SenudaHR/Buck-Converter-Design/README.md

# Design-and-Implementation-of-a-Buck-Converter-for-DC-Voltage-Regulation
