SenudaHR/Buck-Converter-Design/Project Report.pdf

Department of Electronic & Telecommunication Engineering, University of Moratuwa, Sri Lanka.

# Design and Implementation of a Buck Converter for DC Voltage Regulation

Group Members:
230130E | Deshan W. U.
230138K | Dhananjaya K. T. G. T. N.
230155J | Dissanayaka D. M. D. P.
230548R | Ratnayake R. M. S. H.

Submitted in partial fulfilment of the requirements for the module EN2111 Electronic Circuit Design

Date: June 23, 2026

Closed Loop Buck Converter | Group 10

## Contents

1 Introduction and Functionality | 2
2 System Architecture | 3
3 Detailed Design | 6
4 Component Selection | 8
5 Software Simulation | 10
6 Analysis & Discussion | 12
7 Challenges and Future Improvements | 16
A Overall Circuit Diagram | 18

1

## 1 Introduction and Functionality

DC voltage regulation is vital for delivering stable power to sensitive electronics. While simple, linear regulators waste excessive energy as heat. This project implements a step-down (Buck) Switch-Mode Power Supply (SMPS) to efficiently convert a 15 V input down to a regulated 3 V to 12 V output at a 1 A load current.

### 1.1 System Operational Overview

As illustrated in Figure 1, the system maintains a stable output voltage via a continuous closed-loop feedback mechanism consisting of four main stages:

- Power Stage: Uses an IRF3205 MOSFET switch and a 1N5819 freewheeling diode alternating at 18 kHz to chop the input voltage. A second-order LC low-pass filter smooths this chopped signal into a clean DC output.
- Feedback Network (K): A resistive voltage divider continuously samples the output voltage (VOUT ) and scales it down to safe signal levels for the control circuitry.
- Error Amplifier (A(s)): An NE5532 op-amp compares the scaled feedback voltage against a highly stable 2.495 V reference from an LM431 regulator. It amplifies the error and provides compensation to stabilize the loop and eliminate steady-state error.
- PWM Modulator (Fm): Compares the amplified error signal with a locally generated 20 kHz triangular wave to create a variable duty cycle (D) pulse-width modulated signal. This signal is sent to the IR2110 gate driver to turn the power MOSFET on and off.

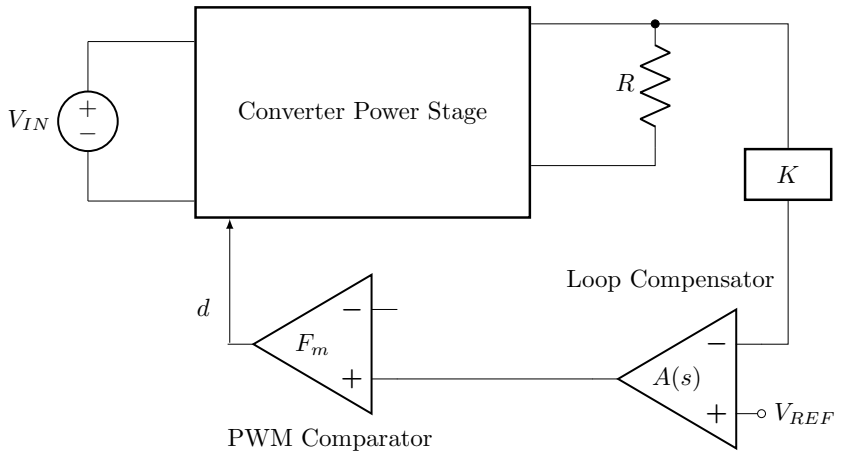
[picture p2: figure]
+ VIN; Converter Power Stage; PWM Comparator; Loop Compensator; VREF

Figure 1: Block Diagram of the System

2

## 2 System Architecture

### 2.1 Triangular Waveform Generation

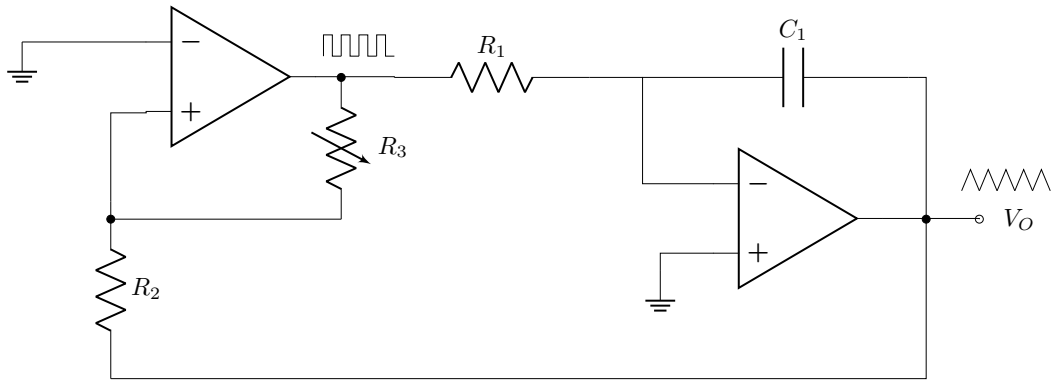
[picture p3: figure]

Figure 2: Circuit Diagram of Triangular Waveform Generator

### 2.1.1 Design for Required Specifications

Given: f = 20 kHz and Vo(pp) = 12 V (For Triangular Waves). Assume the Op-Amp saturation voltage as Vsat = ±7.5 V. For amplitude,

Vo(pp) = 2

R2
R3

Vsat

Let’s take R3 as 10 kΩ and substituting values,

12 = 2

R2
10

× 7.5

Therefore, R2 = 8 kΩ.
Choose standard values as R2 = 8.2 kΩ For frequency,

f =

R3
4R1CR2
Substituting known values,

20 × 10³ =

10 × 10³
4 · R1 · C · 8.2 × 10³

R1C = 1.5244 × 10⁻⁵

Choose C = 10 nF.
Then,

R1 =

1.5244 × 10⁻⁵
10 × 10⁻⁹

= 1524.4 Ω

Choose the nearest standard value: R1 = 1.5 kΩ. Final component values are:
R1 = 1.5 kΩ, R2 = 8.2 kΩ, R3 = 10 kΩ and C = 10 nF.

3

### 2.2 Buck Converter Design - Basic Calculations

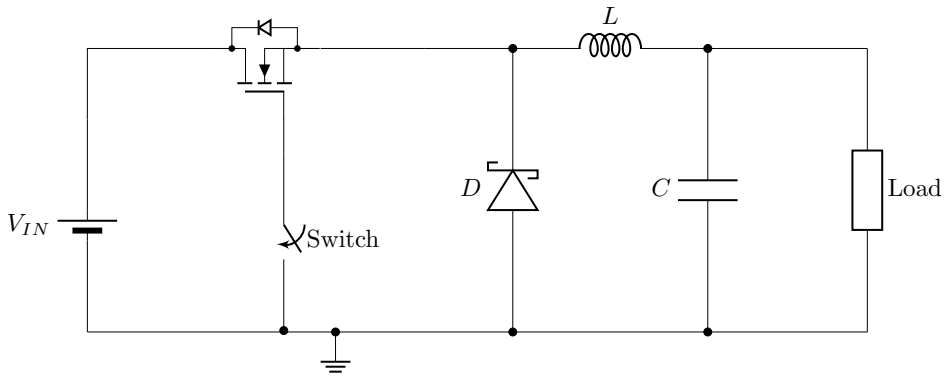
[picture p4: figure]
VIN; Load; Switch

Figure 3: Circuit Diagram

Buck converter equations relate input voltage (Vin), output voltage (Vout), duty cycle (D), switching frequency (fs) and component values (L, C) to achieve step-down DC-DC conversion. These equations are typically derived assuming Continuous Conduction Mode (CCM).

### 2.2.1 Calculations

Target Inductor Ripple Current (∆IL

): As a rule of thumb, we can choose 10% of output current.

∆IL = 10% × Iout = 0.1 × 1 = 0.1 A

Target Inductor Ripple Voltage Also, as a rule of thumb, we can take the Voltage Ripple (∆Vout ) as 1% of output voltage.
∆Vout = 1% × 12 = 0.12 V
Duty Cycle Calculation:

D =

Vout

Vin

Dmin =

3
15

= 0.2, Dmax =

12
15

= 0.8

Inductor Calculation (worst case at Vout = 12 V ):

L =

Vout(1 − D)
fs · ∆IL

L =

12(1 − 0.8)
18000 × 0.1

=

12 × 0.2
1800 | = 0.00133 H = 1.33 mH

Capacitor Calculation:

C = | ∆IL
8fs · ∆Vout

C =

0.1
8 × 18000 × 0.03
| = 23.148 µF

Peak Inductor Current:

IL,peak = Iout +

∆IL
2

= 1 +

0.1
2

= 1.05 A

4

Note

All formulae above assume an ideal buck converter (no losses, ideal components and operation in Continuous Conduction Mode).

### 2.3 Feedback Voltage Divider

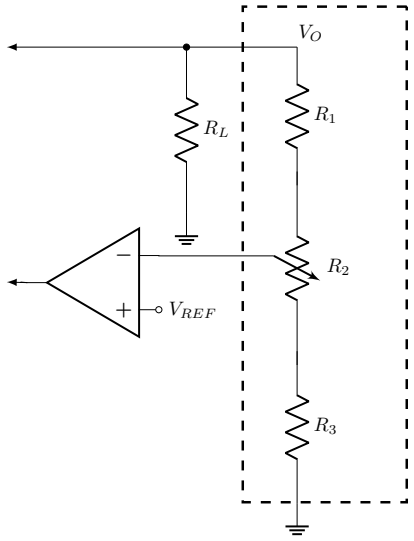
[picture p5: figure]

Figure 4: Feedback Voltage Divider Circuit Diagram

To achieve the target output voltage range of 3.0 V to 12.0 V using a 2.5 V reference voltage (VREF), the feedback resistor network parameters were established. Based on a fixed potentiometer value of 100 kΩ for R2, the required values for the upper limiting resistor (R1) and lower biasing resistor (R3) were determined to ensure proper scaling across the full adjustment range.
R1 = 26.67 kΩ ≈ 27 kΩ and R3 = 33.33 kΩ ≈ 33 kΩ were selected.

2.4 2.5V Reference Voltage Generation

To provide a stable reference voltage of 2.5 V for the system, an LM431 adjustable shunt regulator is utilized. Because the target output voltage matches the internal reference voltage (Vref = 2.5 V), the device is configured without an external feedback voltage divider by directly shorting the reference (REF) pin to the cathode node.
Operating from a 15 V input supply rail, a 5.6 kΩ current-limiting bias resistor (Rcl) was selected. The nominal quiescent current (IK) flowing through the regulator is determined by Ohm’s Law as shown in Equation 1:

IK =

Vin − Vout

Rcl

=

15 V − 2.5 V
5.6 kΩ | ≈ 2.23 mA | (1)

This design choice ensures that the bias current remains safely above the LM431’s minimum required operating current (Imin = 1 mA) to maintain tight regulation, while keeping overall power dissipation minimal.

5

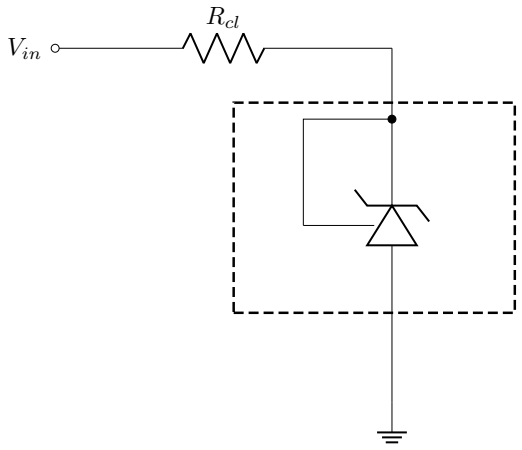
[picture p6: figure]
Rcl; Vin

Figure 5: LM431 configured for a fixed 2.5V output from a 15V rail.

## 3 Detailed Design

### 3.1 Average Small Signal Switch Modelling

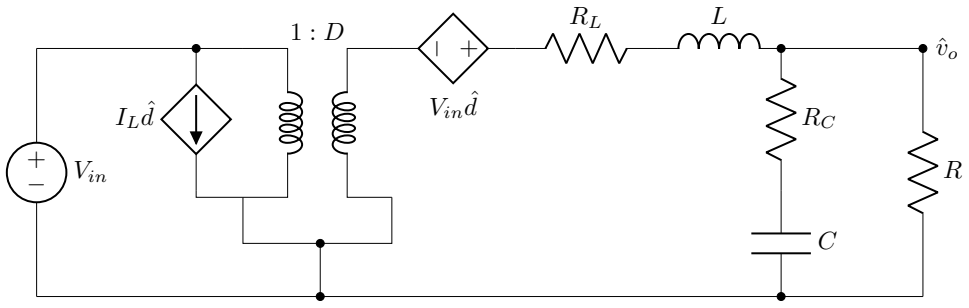
[picture p7: figure]
Vin; Vin ˆd; vˆo

Figure 6: Small Signal Average Model of three Terminal PWM Switch

The control to output transfer function, vˆo(s)
dˆ(s)

is given by,

vˆo(s)
ˆd(s)

= Vin ·

1 + s
ωz
1 + s
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
, ωz =

1
RC C

, ω0 ≈

1
√
LC

We have chosen C = 470 µF, L = 10 mH, and RC measured as

fLC =

1
2π

√
10 × 10⁻³ × 470 × 10⁻⁶

≈ 73.412 Hz

fz,ESR =

1
2π · RESR · C

=

1
2π × 0.2 × 470 × 10⁻⁶

≈ 1693 Hz

The Power Stage transfer function Gplant(s) can be written as,

Gplant(s) = Fm ·

vˆo(s)
ˆd(s)

(3)

6

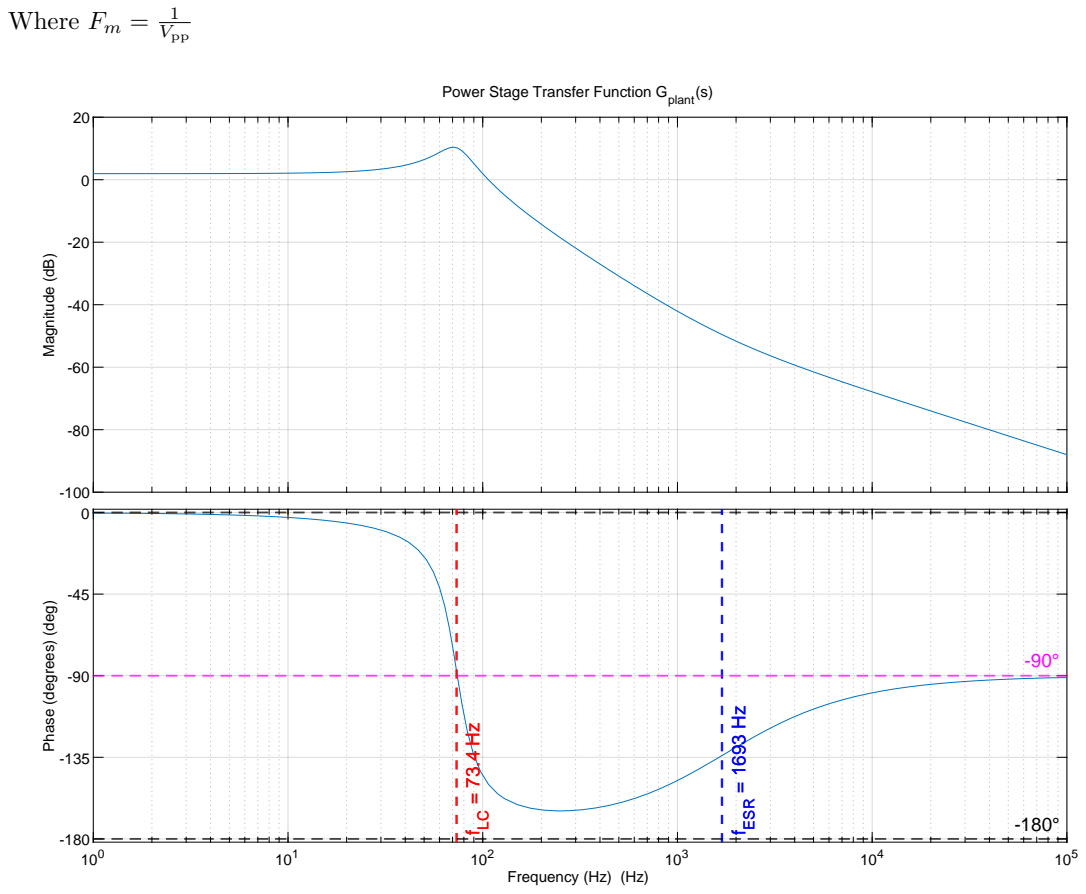
[picture p8: figure]
Where Fm =; Vpp; Magnitude (dB); Phase (degrees) (deg); fLC = 73.4 Hz; fESR = 1693 Hz; Power Stage Transfer Function Gplant(s); Frequency (Hz) (Hz)

Figure 7: Power Stage Bode Diagram

### 3.2 Compensator Design

Compensator transfer function is given by,

Gc(s) = −

1
sR1C1

·

s +

1
R2C2
s +

1
R2C1

(4)

The compensator introduces:

- A zero at ωz = −

1
R2C2
- A pole at ωp = −

1
R2C1
- An integrator pole at DC (ensures zero steady-state error)

7

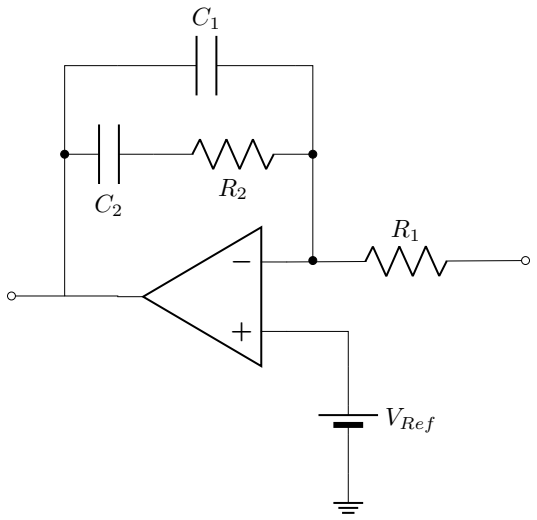
[picture p9: figure]
VRef

Figure 8: Type II compensator

Closed-loop requirements:

- cross-over frequency: fc = 1000 Hz (< 0.1f) Phase Margin: PM = 60◦

ωc = 2πfc = 6283.185 rad/s

At the cross-over frequency,

PM − 180◦ = ∠F(jωc) + ∠Gc(jωc) + ∠M(jωc)

∠M(jωC ) = 0 and ∠F(jωC ) = −145◦ ⇒ ∠GC (jωC ) = 25◦

|F(jωc)Gc(jωc)M(jωC )| = 1

. Therefore, |F(jωc)| = 98.42
Using K-Factor Method, we can find,

K = tan
∠GC (jωC )
2
= 0.2217

Then

ωz = ωc

r
1 − K
1 + K

!
ωp = ωc

r
1 + K
1 − K

!

Then, ωz = 5015 rad/s and ωp = 7872.06 rad/s. Taking R2=22 kΩ, C1 = 10 nF and C2 = 5.6 nF. R1 is a part of feedback voltage divider described in section 2.3.

## 4 Component Selection

The selection of components is based on the design requirements of a switching frequency (fs) of 18 kHz, an output current of 1 A and an input voltage range up to 15 V. The following components were selected based on their performance, availability and compatibility with high-speed switching.

8

### 4.1 Power MOSFET: IRF3205

The IRF3205 was selected as the main switching element. The primary criteria for selection were low ON-resistance (RDS(on)) and high current handling.

- Voltage Rating: It has a Drain-to-Source breakdown voltage (VDSS) of 55 V, which provides a safety margin of over 200% for our 15 V input.
- Current Rating: Capable of handling up to 110 A continuous drain current. Our peak current is only 1.05 A, ensuring the device operates far below its thermal limits.
- Efficiency: With an RDS(on) of only 8 mΩ, the conduction power loss is negligible:

Pcond = I

2

out × RDS(on) = (1)² × 0.008 = 8 mW

### 4.2 MOSFET Driver: IR2110

Driving a High-Side N-channel MOSFET requires a gate voltage higher than the input voltage (Vin + VGS). The IR2110 is a high-voltage, high-speed power MOSFET driver with independent high and low-side referenced output channels.

- Floating Channel: It uses a bootstrap circuit to provide the necessary gate-to-source voltage for the high-side IRF3205.
- Switching Speed: It offers typical rise/fall times of 25ns/17ns. This is critical for minimizing switching losses at 20 kHz, ensuring the MOSFET transitions quickly through the linear region.
- Drive Current: With a peak output current of 2 A, it can rapidly charge the gate capacitance (Ciss) of the IRF3205.

### 4.3 Operational Amplifier: NE5532

For the triangular wave generator and the error amplifier (compensator), the NE5532 was chosen over standard op-amps like the LM741 or TL082.

- Slew Rate: It features a high slew rate of 9 V/µs. This is essential for generating a clean 20 kHz triangular wave without “rounding” the peaks.
- Bandwidth: A unity-gain bandwidth of 10 MHz ensures that the control loop responds quickly to load transients.
- Low Noise: As a high-performance audio op-amp, it provides low input noise, which is beneficial for the stability of the PWM comparator.

### 4.4 Voltage Reference: LM431

To maintain a stable output voltage, the feedback loop requires a precise reference voltage (VREF ).

- Precision: The LM431 provides a programmable output reference of 2.5 V with high thermal stability.
- Regulation: It replaces a simple Zener diode because it offers a much sharper “turn-on” knee and lower dynamic impedance, ensuring the control loop compares the output against a rock-steady baseline despite input voltage fluctuations.

9

### 4.5 Freewheeling Diode: 1N5819 Schottky Barrier Rectifier

The 1N5819 Schottky diode was selected to provide the freewheeling path during the MOSFET off-state based on the following justifications:

- Negligible Reverse Recovery (trr ≈ 0 ns): Unlike slow silicon P-N diodes (e.g., 1N4007), the metal-to-silicon Schottky junction switches instantly at 18 kHz, eliminating reverse recovery power losses and voltage ringing.
- Low Forward Voltage Drop (VF ≈ 0.45 V): The low drop reduces worst-case diode conduction losses (Dmin = 0.2) to just 0.36W, a 59% reduction in power dissipation compared to a standard silicon diode (0.88W).
- Safe Operating Margins: The diode’s 40 V reverse breakdown rating provides a 2.67× safety factor against the 15 V input voltage rail and its 1.0 A average forward current rating perfectly matches the maximum 1 A load requirement.

## 5 Software Simulation

### 5.1 Triangle Waveform Generation

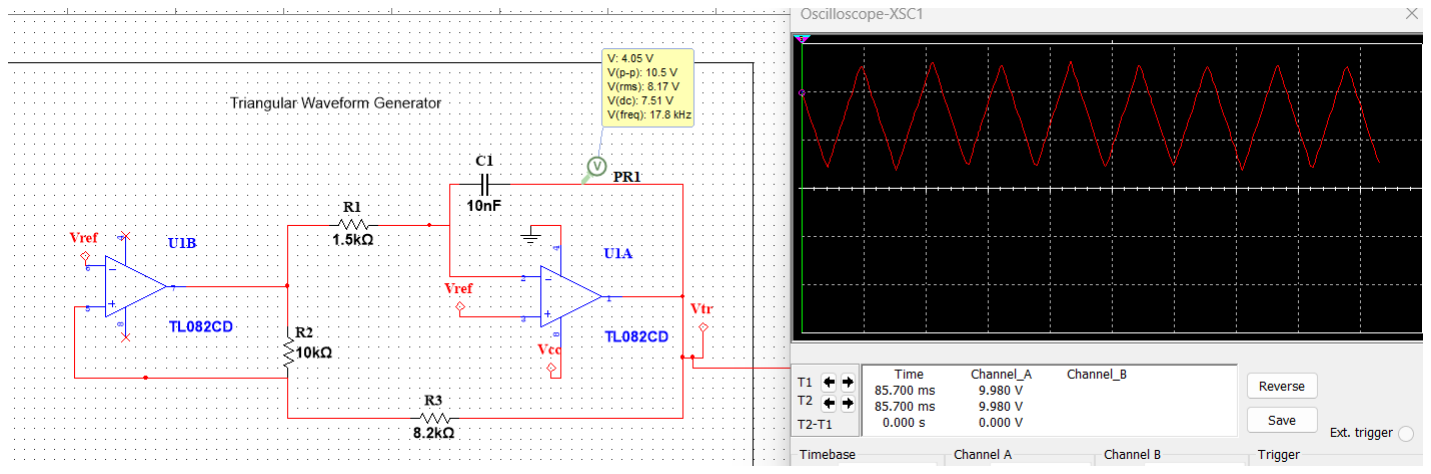
[picture p10: figure]

Figure 9: Simulation Results of Triangle waveform Generator (Using NI Multisim)

Table 1: Comparison of Theoretical and Simulated Values for Triangular Waveform Generator

Parameter | Theoretical Value | Simulated Value | Percentage Error (%)
Frequency (f) Peak-to-Peak (Vpp) Center Voltage (Vdc) | 20.0 kHz 12.0 V 7.5 V | 17.8 kHz 10.5 V 7.52 V | 11.0% 12.5% 0.27%

### 5.2 Buck Converter Simulations

To validate the theoretical design of the buck converter, the ideal calculated values were compared against simulation results obtained at a switching frequency of 18 kHz. Table presents the side-byside comparison of the inductor current ripple (∆IL) and output voltage ripple (∆Vout) for both the 3 V and 12 V operating conditions.

10

Output | Parameter | Theoretical | Simulated
3 V | Current Ripple (∆IL) Voltage Ripple (∆Vout) | 13.33 mA 197 µV | 19.0 mA 225 µV
12 V | Current Ripple (∆IL) Voltage Ripple (∆Vout) | 13.33 mA 197 µV | 27.3 mA 99.2 µV

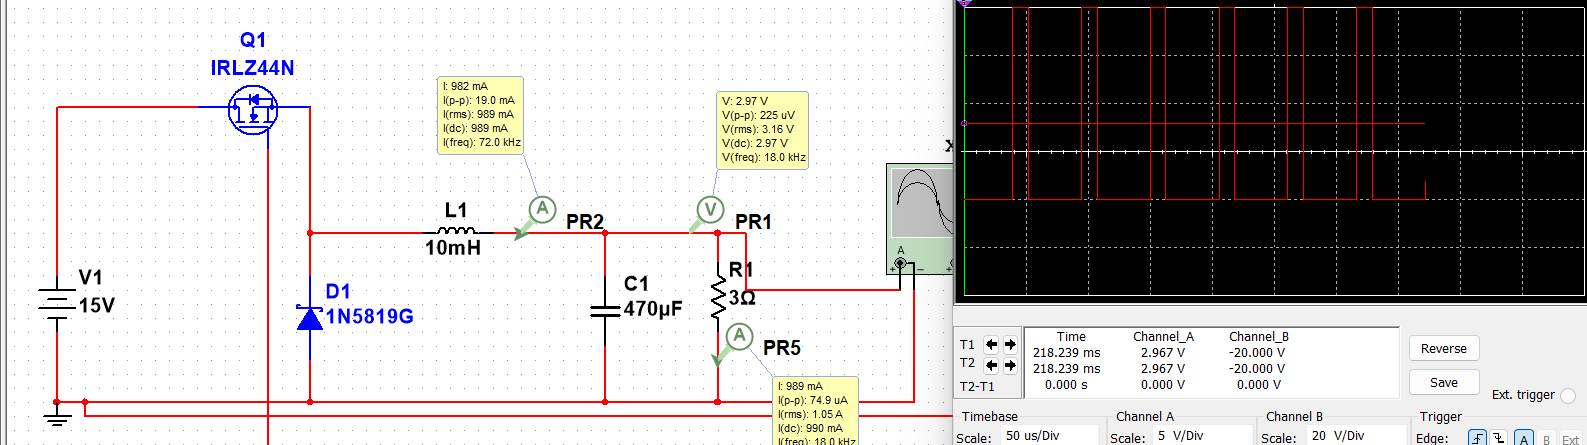
[picture p11: figure]

Figure 10: Simulation Results for VO=3 V

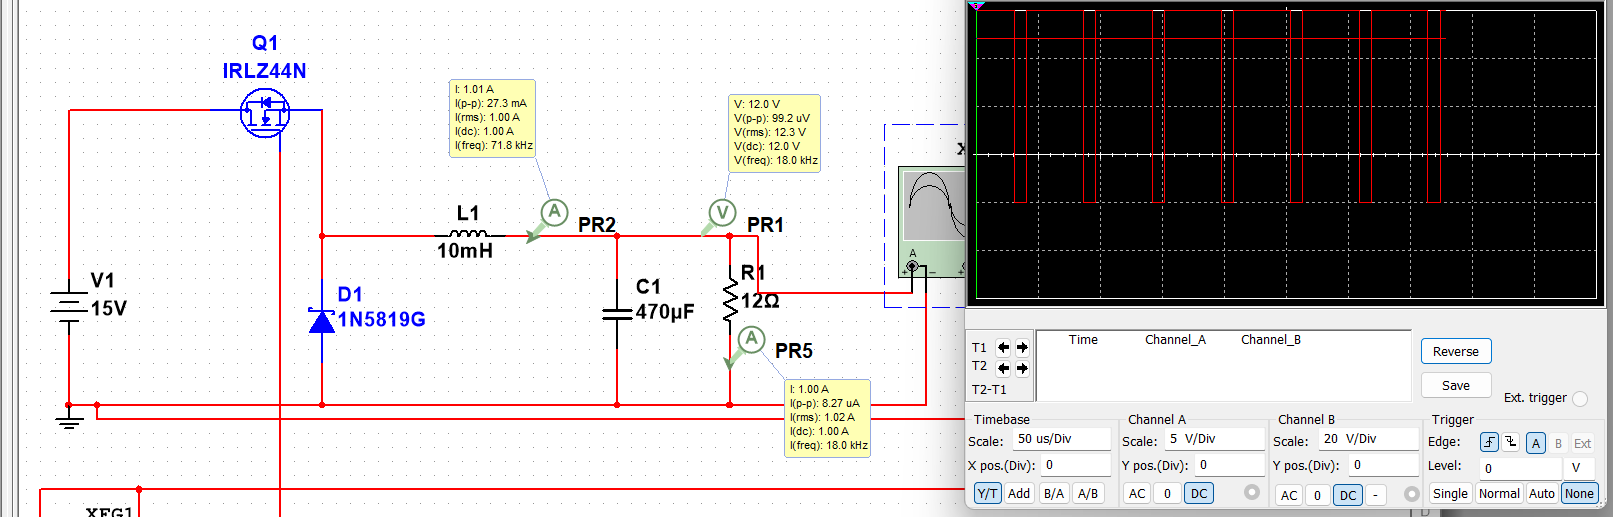
[picture p12: figure]

Figure 11: Simulation Results for VO=12 V

The mathematical expressions for an ideal buck converter dictate identical ripple magnitudes at both operating points because the product Vout(1 − D) evaluates to a constant 2.4 V. However, the simulated data reveals noticeable variances:

- Inductor Current Ripple: The simulation yields higher current ripples (19.0 mA and 27.3 mA) than the ideal baseline. This shift is primarily attributed to non-ideal switches, diode forward voltage drops, and internal inductor DC resistance (DCR), which alter the effective voltage across the inductor (VL) during the conduction phases.
- Output Voltage Ripple: At 3 V, the simulated voltage ripple increased to 225 µV, a typical consequence of introducing Capacitor Equivalent Series Resistance (ESR). Conversely, the lower voltage ripple observed at 12 V (99.2 µV) indicates dampening effects within the simulation loop, potentially influenced by higher continuous damping losses or software solver convergence constraints at high duty cycles.

11

## 6 Analysis & Discussion

### 6.1 Triangle Waveform Generation

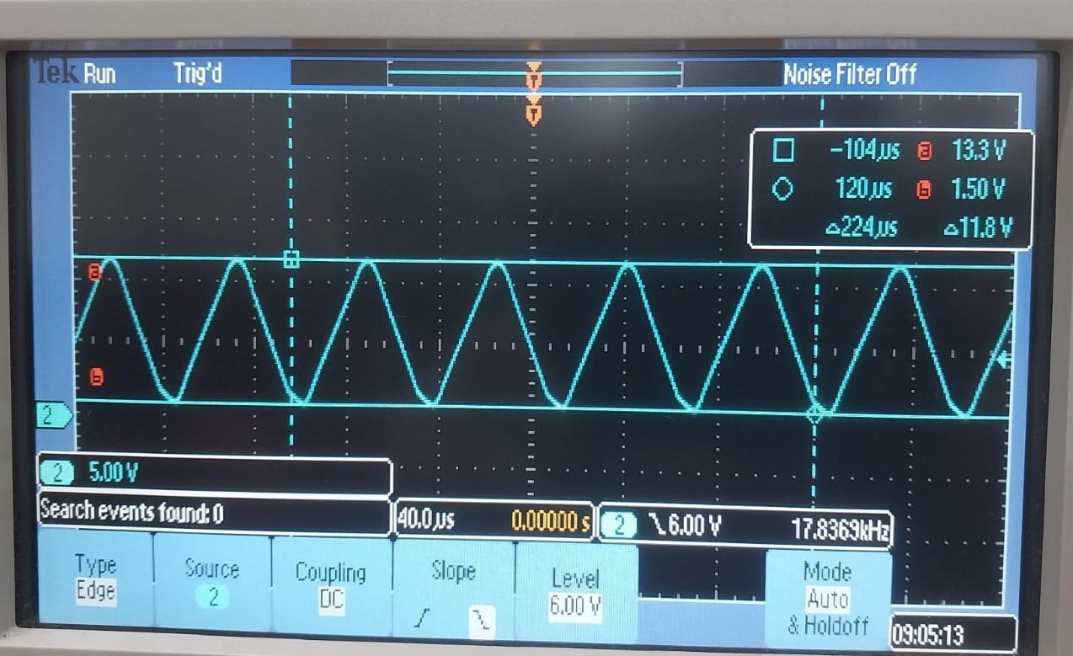
[picture p13: figure]

Figure 12: Triangular Waveform Output

The total power dissipation (P) of the triangular waveform generator is calculated using the supply voltage (V ) and the load current (I) as shown in Equation 5.

P = V × I = 15 V × 6 mA = 90 mW | (5)

Table 2: Updated Performance and Operating Parameters of the Generator

Parameter | Practical Value | Theoretical Value | Percentage Error (%)
Frequency (f) Peak-to-Peak (Vpp) Center Voltage (Vdc) | 17.8 kHz 11.8 V 7.4 V | 20 kHz 12 V 7.5 V | 11.00% 1.67% 1.33%

### 6.2 Reference Voltage Stability

6 | 8 | 10 | 12 | 14 | 16 | 18 | 20

2.5084

2.5086

2.5088

2.509

2.5092

Input Voltage VIN (V)

Output Voltage

VOUT (V)

LM431 Output Voltage vs. Input Voltage

Figure 13: LM431 Line Regulation Performance Plot

12

### 6.3 Line Regulation Analysis

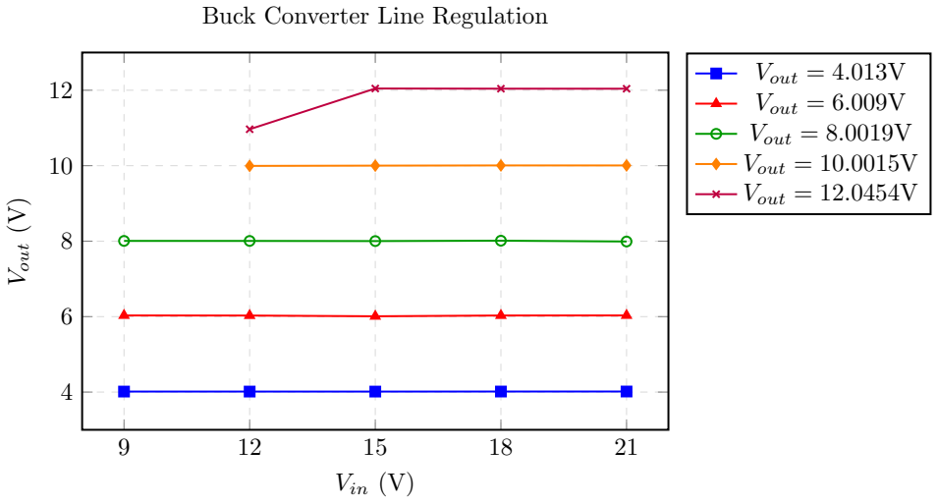
[picture p14: figure]
Vin (V); Vout (V); Buck Converter Line Regulation; Vout = 4.013V Vout = 6.009V Vout = 8.0019V Vout = 10.0015V Vout = 12.0454V

Figure 14: Line Regulation: Output Voltage vs. Input Voltage.

Table 3: Line Regulation Data Table (In Volts)

| Vin
Vout | 9 | 12 | 15 | 18 | 21
4.013 | 4.0135 | 4.0133 | 4.013 | 4.0143 | 4.0149
6.009 | 6.0305 | 6.028 | 6.009 | 6.0292 | 6.031
8.0019 | 8.0064 | 8.0057 | 8.0019 | 8.012 | 7.9908
10.0015 | | 9.9944 | 10.0015 | 10.0067 | 10.0063
12.0454 | | 10.966 | 12.0454 | 12.0408 | 12.04

### 6.4 Load Regulation Analysis

Table 4: Load Regulation Performance Under Various Loads

Load | Vout Without Load (V)
Resistance | 3.0247 | 4.0004 | 6.0419 | 8.0399 | 10.0147 | 11.9926
22 Ω | 3.0239 | 2.0755 | 5.54 | 5.547 | 5.6 | 5.6302
100 Ω | 3.0236 | 3.9933 | 6.0332 | 8.0254 | 9.9934 | 11.06
220 Ω | 3.0231 | 3.9983 | 6.0377 | 8.0313 | 10.0008 | 11.9762
470 Ω | 3.0237 | 3.9994 | 6.0394 | 8.0354 | 10.0054 | 11.9823
1 kΩ | 3.0246 | 3.9997 | 6.0405 | 8.0365 | 10.0079 | 11.9892
3.3 kΩ | 3.0246 | 4.0001 | 6.0418 | 8.0382 | 10.011 | 11.9917
10 kΩ | 3.0243 | 4.0002 | 6.042 | 8.0394 | 10.0115 | 11.9928
100 kΩ | 3.0234 | 4.0003 | 6.0418 | 8.0389 | 10.012 | 11.9921
1 MΩ | 3.0247 | 4.0004 | 6.0419 | 8.0399 | 10.0147 | 11.9926

13

10¹ | 10² | 10³ | 10⁴ | 10⁵ | 10⁶

2

4

6

8

10

12

Load Resistance RL (Ω)

Output Voltage

Vout (V)

Buck Converter Load Regulation

VNL = 3.0247 V
VNL = 4.0004 V
VNL = 6.0419 V
VNL = 8.0399 V
VNL = 10.0147 V
VNL = 11.9926 V

Figure 15: Load Regulation Graph: Output Voltage vs. Load Resistance (RL).

### 6.5 Load Current Analysis

Buck Converter Load Current vs. Load Resistance

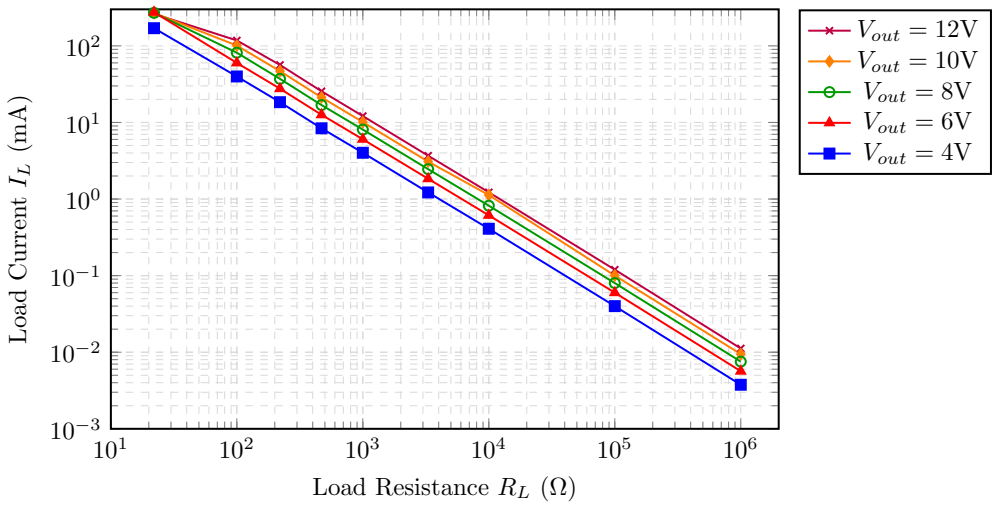
[picture p15: figure]
Load Resistance RL (Ω); Load Current; Vout = 12V Vout = 10V Vout = 8V Vout = 6V Vout = 4V

Figure 16: Load Current (mA) vs. Load Resistance across different target output voltages.

### 6.6 Converter Efficiency Analysis

Note on Quiescent Auxiliary Overhead: A permanent base supply operating current of 9 mA (135 mW power) flows through the circuit under absolute no-load conditions. This constant residual overhead is consumed continuously by active signal conditioning elements, including the PWM triangle carrier wave ramp generator, high-speed comparative latch blocks, and error amplifier compensation loops. As a result, when operating at light loads (RL ≥ 10 kΩ), this internal circuit overhead dominates total energy consumption, leading to a sharp drop toward zero efficiency.

14

Buck Converter Efficiency vs. Load Current

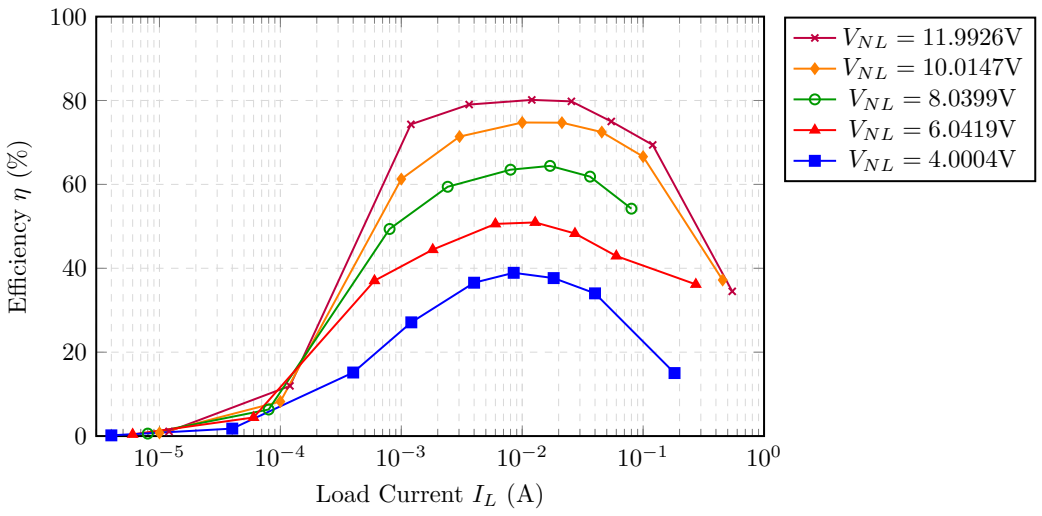
[picture p16: figure]
Load Current IL (A); Efficiency; VNL = 11.9926V VNL = 10.0147V VNL = 8.0399V VNL = 6.0419V VNL = 4.0004V

Figure 17: Converter Efficiency (%) versus Load Current (IL) at Vin = 15 V.

### 6.7 Power Stage Efficiency Analysis

4 | 6 | 8 | 10 | 12

80

85

90

95

100

Output Voltage Vout (V)

Power Stage Efficiency

η (%)

Buck Converter Power Stage Efficiency (1 kΩ Load)

RL = 1 kΩ (Power Stage Only)

Figure 18: Power stage conversion efficiency vs. output voltage (Vin = 15 V).

15

### 6.8 Diode Voltage Waveforms in a Buck Converter

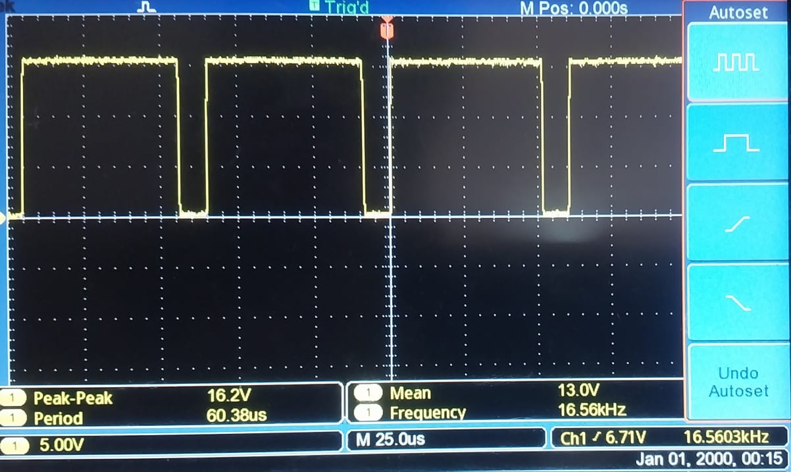
[picture p17: figure]

Figure 19: Diode Voltage Waveforms in a Buck Converter

### 6.9 Output Voltage Waveform

The output voltage (Vout) of the buck converter was measured across the load capacitor using a digital storage oscilloscope. The resulting experimental waveform is displayed in Figure 20.

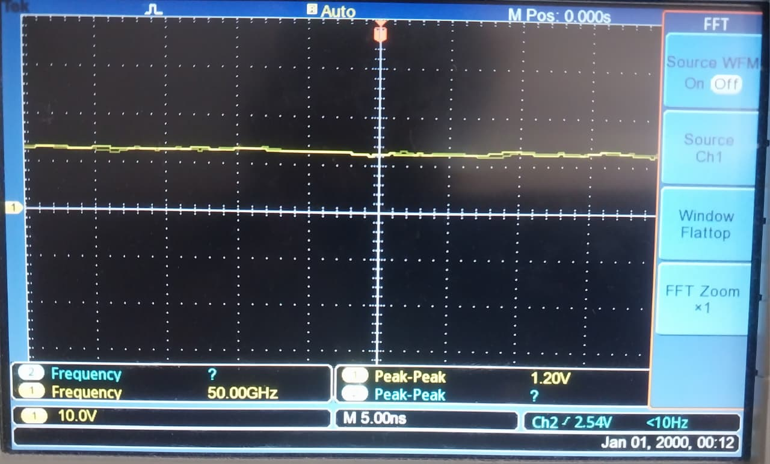
[picture p18: figure]

Figure 20: Oscilloscope capture of the buck converter output voltage (Vout).

The frequency measurement reads an anomalous 50.00 GHz. This occurs because the ripple signal is so small and smooth that the oscilloscope’s hardware counter is triggering on background random noise rather than the actual switching frequency.

## 7 Challenges and Future Improvements

### 7.1 Main Technical Challenges

1. Limitations in Switching Frequency Realization
While standard switch-mode power supplies (SMPS) typically operate in the 100 kHz to 500 kHz range to optimize passive component sizing, this fully analog implementation was constrained to a maximum stable switching frequency of 20 kHz. Extensive experimental iterations were conducted using high-slew-rate operational amplifiers, including the TL072, TL082 etc; however, due to real-world bandwidth degradation, non-ideal component tolerances, and severe parasitic characteristics found in locally sourced IC batches, these devices failed to stably generate the required high-frequency carrier wave.

Consequently, the NE5532 dual low-noise operational amplifier was utilized as the structural workaround. The resulting low switching frequency introduced substantial downstream hard-

16 ware constraints, primarily making it exceptionally difficult to source high-inductance components capable of handling the rated power stage saturation currents within the local market. This bottleneck ultimately forced the deployment of a physically over-sized, bulky inductor core, compromising the power density of the converter.

2. High Quiescent Analog Power Dissipation
Because the entire control topology—including the triangle carrier wave oscillator, error amplifier feedback networks, and PWM comparator blocks—was implemented using discrete, active analog sub-circuits, a continuous and substantial power overhead was observed. Under absolute no-load conditions (IL = 0 A), the control circuitry maintains a static baseline current draw of 9 mA directly from the 15 V main supply. This fixed 135 mW power consumption severely hurts the overall system efficiency profile, particularly when evaluating operation under lightload or high-resistance conditions, where the auxiliary control losses completely dominate the input power envelope.

### 7.2 Proposed Future Improvements

To mitigate the structural drawbacks identified during empirical evaluation, the following design improvements are proposed for future revisions of the system:

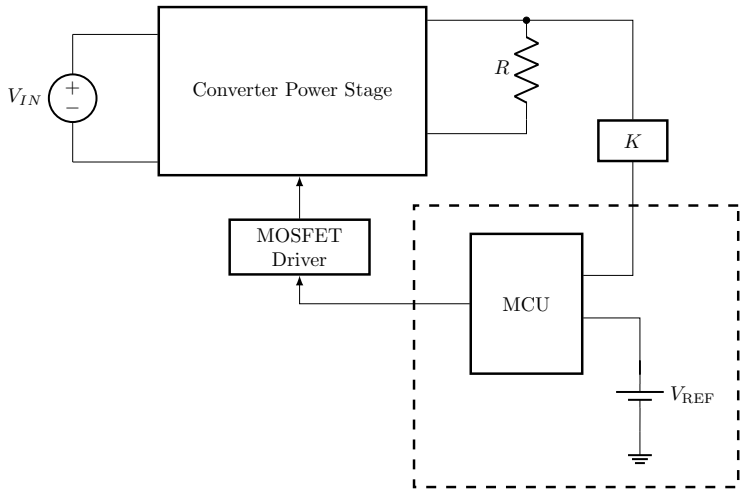
[picture p19: figure]
+ VIN; Converter Power Stage; MCU; MOSFET Driver; VREF

Figure 21: Mixed-Signal Architecture Block Diagram

To replace the continuous-time analog error amplifier with the digital architecture shown in Fig. 21, the controller is implemented as a discrete-time recursive difference equation.

## References

[1] J. G. Kassakian, M. F. Schlecht, and G. C. Verghese, Principles of Power Electronics. Reading, MA: Addison-Wesley, 1991. ISBN: 9780201096897.
[2] Texas Instruments, Buck Converter Modeling, Control and Compensator Design
[3] EEEguide, “Triangular Wave Generator using Op-amp,” [Online]. Available: https://www.eeeguide.com/triangular-wave-generator-using-op-amp/.
[4] EPCI Passive Components Europe, “Buck Converter Design and Calculation,” Pas-
sive Components Magazine, | [Online]. Available: | https://passive-components.eu/
buck-converter-design-and-calculation/. (https://passive-components.eu/buck-converter-design-and-calculation/)

17

## A Overall Circuit Diagram

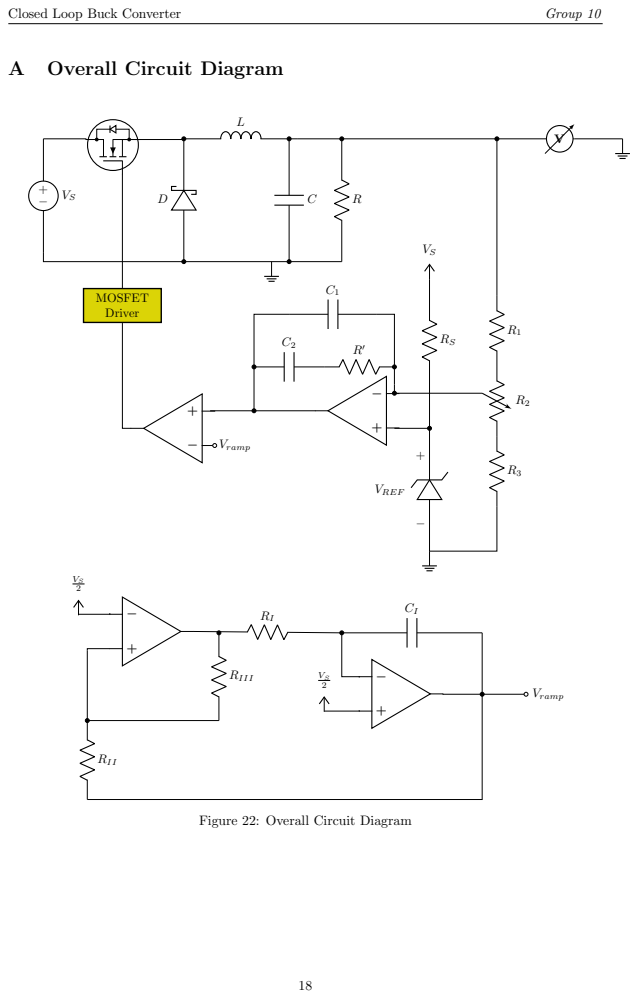
[picture p20: page 19]
VREF; MOSFET Driver; Vramp; RIII; RII

Figure 22: Overall Circuit Diagram
