SenudaHR/Buck-Converter-Design/Project Proposal.pdf

## Design and Implementation of a Buck Converter for DC Voltage Regulation

Deshan W. U.(230130E)
Dhananjaya K. T. G. T. N.(230138K) Dissanayake D. M. D. P.(230155J) Ratnayake R. M. S. H.(230548R) Department of Electronic and Telecommunication Engineering, University of Moratuwa

March 22, 2026

## 1 Introduction

Efficient power conversion is an essential requirement in modern electronic systems. DC–DC converters are widely used to regulate and convert voltage levels to meet the requirements of various electronic devices. Among these converters, the buck converter is one of the most commonly used topologies for stepping down a higher DC voltage to a lower DC voltage.
This project proposes the design and implementation of a buck converter that demonstrates the fundamental principles of switching power conversion using analogue electronic components. The project aligns with the EN2111 Electronics syllabus by incorporating concepts such as switching devices, passive filtering and power electronic circuit design.

## 2 Project Objectives

The main objectives of this project are:
- To design a buck converter capable of stepping down a DC input voltage.
- To study the relationship between duty cycle and output voltage in switching converters.
- To design an LC filter to minimize output voltage ripple.
- To implement and experimentally test the buck converter circuit.
- To evaluate the performance and efficiency of the converter.

## 3 Methodology

The proposed system consists of several key components including a switching device, diode, inductor, capacitor and a switching signal generation circuit.
First, the theoretical operation of the buck converter will be analysed to determine the relationship between input voltage, duty cycle and output voltage. Based on the required output specifications, suitable values for the inductor and capacitor will be calculated to ensure proper energy storage and to reduce voltage ripple.

1

Buck Converter Design | Group 10

The switching device will operate according to a periodic control signal generated by a switching signal generation circuit. The inductor and capacitor will function as a filter to smooth the switched waveform and produce a stable DC output voltage.
The circuit will initially be simulated using circuit simulation tools such as LTspice or Multisim to verify its functionality. After successful simulation, the design will be implemented as a hardware prototype and tested using laboratory instruments such as oscilloscopes and multimeters to observe switching behaviour and output voltage characteristics.

## 4 Expected Outcomes

The expected outcomes of this project include:
- Successful design and implementation of a buck converter circuit.
- Demonstration of DC voltage step-down using switching techniques.
- Analysis of output voltage ripple and converter efficiency.
- Improved practical understanding of power electronic circuits.
- Experimental validation of theoretical design calculations.

## 5 Resources Required

The following components and tools will be required:
- Switching device (MOSFET or transistor)
- Diode
- Inductor and capacitor components
- Switching signal generation circuit
- Breadboard or PCB for circuit implementation
- DC power supply
- Oscilloscope and digital multimeter
- Circuit simulation software (LTspice / Multisim)

## 6 Conclusion

This project focuses on the design and implementation of a buck converter using analogue electronic components. The converter demonstrates the basic principles of switching power conversion and passive filtering. Through simulation and practical experimentation, the project will provide valuable insight into DC–DC converter operation and analogue circuit design, which are key topics in the EN2111 course.

## References

1. R. L. Boylestad and L. Nashelsky, Electronic Devices and Circuit Theory, 11th ed., Pearson, 2013.
2. N. Mohan, T. Undeland, and W. Robbins, Power Electronics: Converters, Applications, and Design, 3rd ed., Wiley, 2003.
3. Texas Instruments, “Buck Converter Design Basics,” Application Note.

2
