SenudaHR/Buck-Converter-Design/Mid evaluation presentation.pdf

## Design and Implementation of a Buck Converter for DC Voltage Regulation

Udara Deshan | Tharusha Nimesh | Dinusha Dissanayaka
Senuda Ratnayake
| Group 10

Department of Electronic & Telecommunication Engineering, University of Moratuwa, Sri Lanka.

April 28, 2026

Group 10 | Buck Converter Design

# Introduction

A buck converter is a type of DC–DC converter used to step down a higher DC voltage to a lower level efficiently.
- Widely used for voltage regulation in electronic devices
- Uses switching techniques for high efficiency
- PWM generated using op-amp comparator and triangle wave
- Output voltage controlled by duty cycle

Specifications
- Input Voltage: 15 V
- Output Voltage: 3V − 12 V
- Switching Frequency: 16 kHz
- Maximum Load Current: 1 A
- Duty Cycle Range: D = 0.2 to 0.8
- Target Output Ripple Voltage : 1 % of Vout
- Target Inductor Ripple Current : 10 % of Iout
- Maximum output power : 15 W

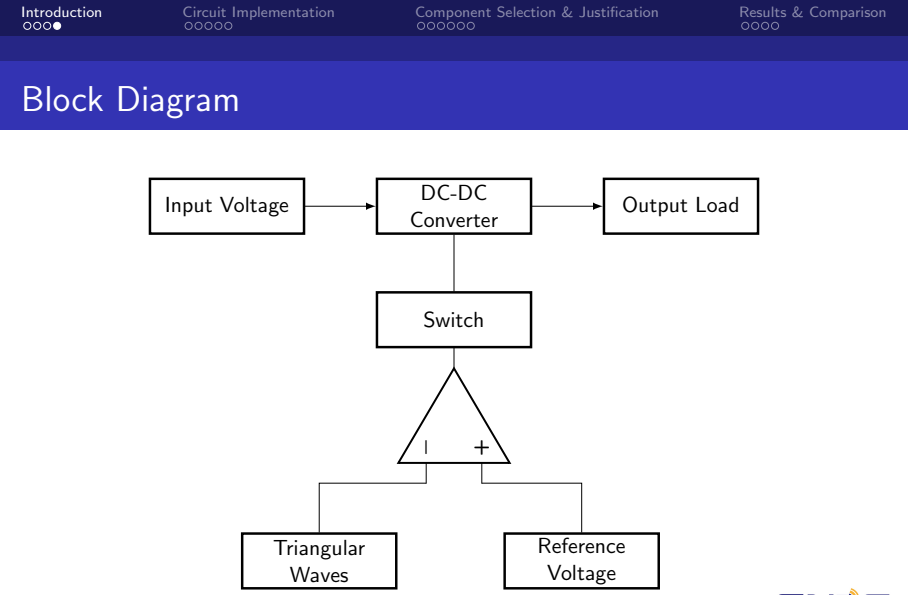
[picture p21: figure]
Block Diagram; Input Voltage; Converter; Output Load; Switch; Triangular Waves; Reference Voltage

# Circuit Implementation

## Triangular Waveform Generator

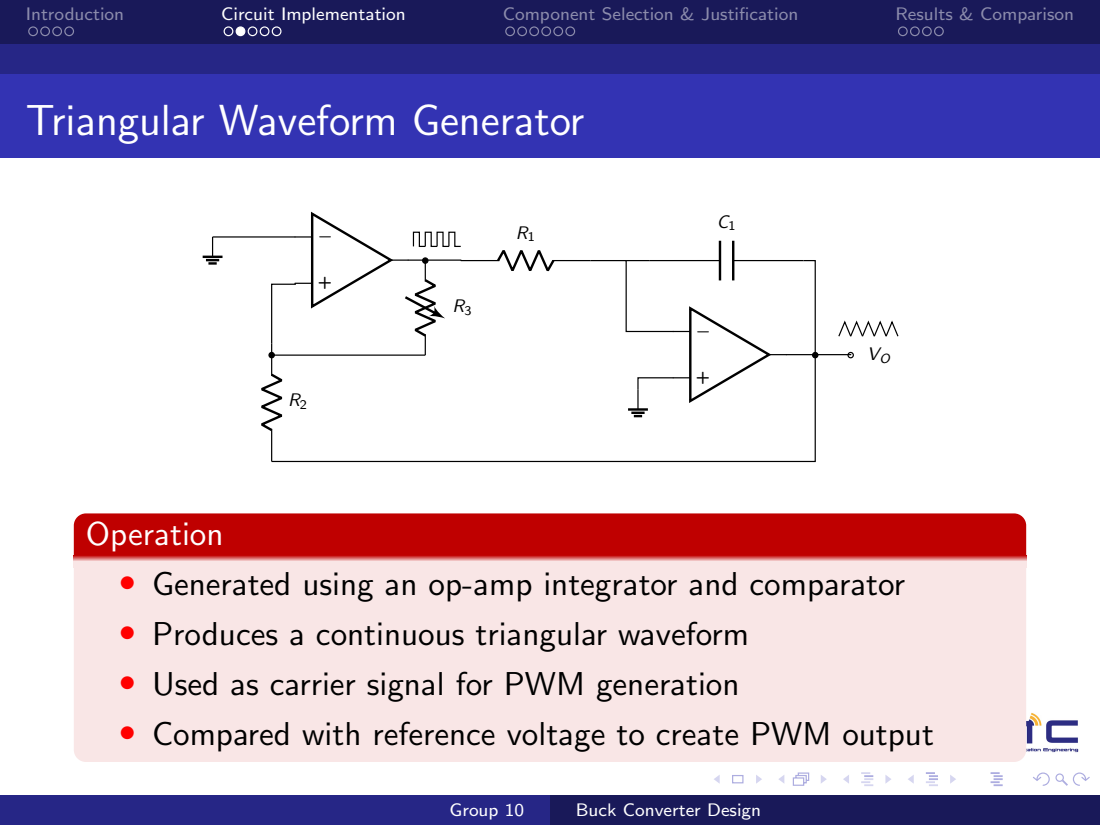
[picture p22: page 7]

Operation
• Generated using an op-amp integrator and comparator
• Produces a continuous triangular waveform
• Used as carrier signal for PWM generation
• Compared with reference voltage to create PWM output

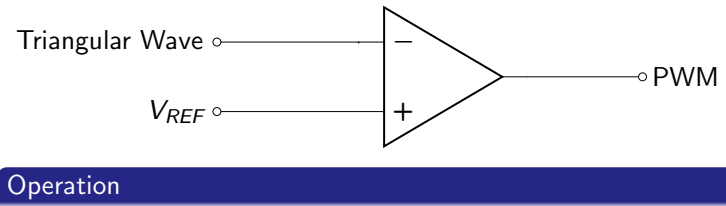
[picture p23: figure]
PWM; VREF; Triangular Wave; Operation

- The comparator acts as a decision-maker by constantly comparing a triangular signal with a target control voltage.
- It outputs a high signal when the control voltage is greater than the reference and a low signal when it is less, converting the intersection points into PWM signal.

## Buck Converter

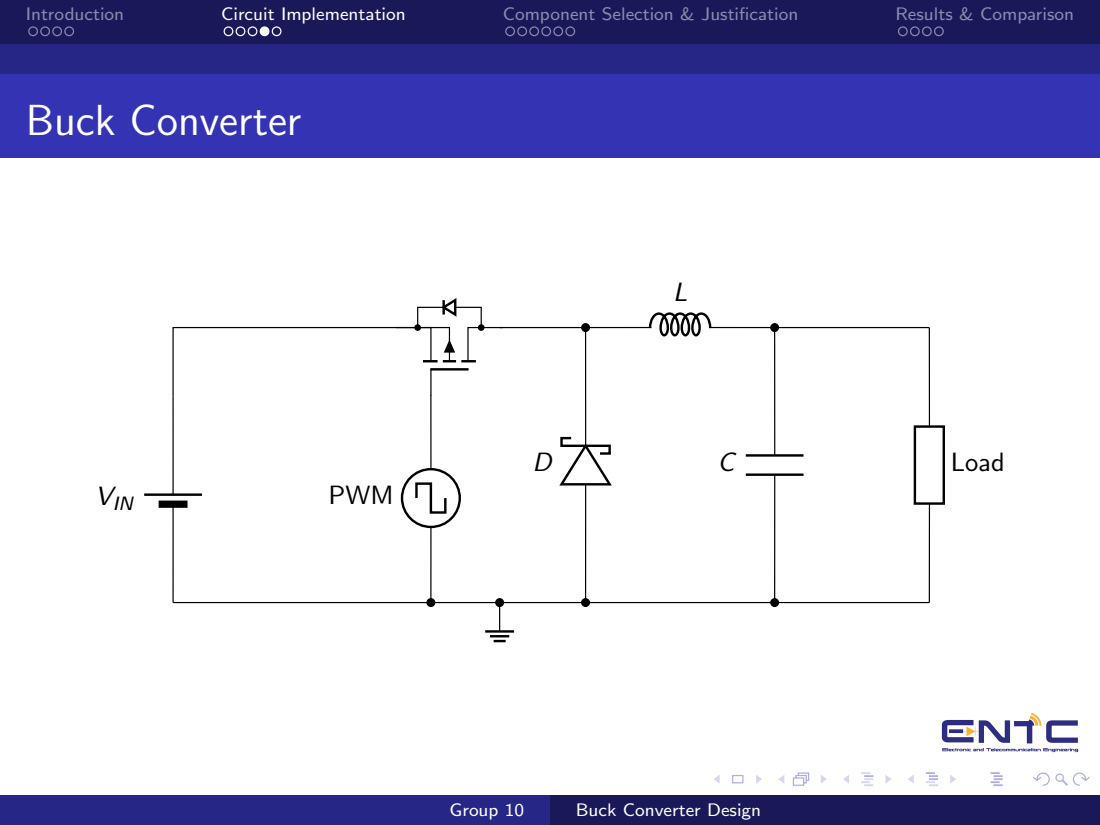
[picture p24: page 9]
VIN; Load; PWM

Circuit Operation
- Input DC voltage Vin is applied to MOSFET switch
- PWM signal controls ON/OFF operation of the switch
- Inductor stores energy during ON state
- Diode provides current path during OFF state
- LC filter smooths output and reduces ripple
- Output voltage depends on PWM duty cycle

# Component Selection & Justification

### 1. Slew Rate Requirement To generate square wave in PWM

generator circuit,

Minimum Required Slew Rate

SR ≥ |Vp · jωe

jωt

| = 7.5 × 2π × 16 × 10³ × 10 = 7.5 V µs

−1

### 2. Gain Bandwidth Requirement To accurately reproduce a

square wave, the op-amp must support higher frequency harmonics.

Minimum Required GBW

GBW ≥ n · f0 = 10 × 15 kHz = 150 kHz

Note: Higher-order harmonics are required to approximate a square wave, which increases the effective slew rate requirement.
In this design, up to the 10th harmonic is considered.

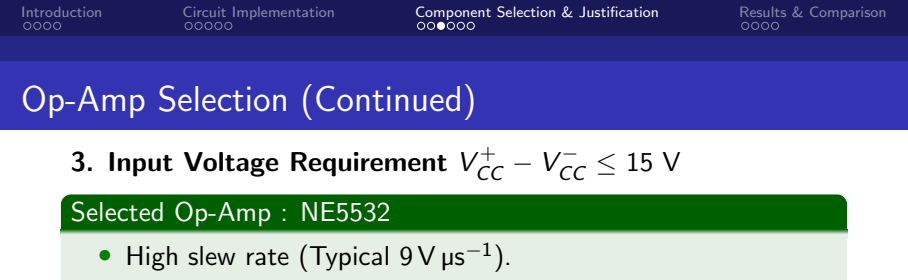
[picture p25: figure]
Op-Amp Selection (Continued); 3. Input Voltage Requirement V; Selected Op-Amp : NE5532

- High slew rate (Typical 9 V µs
- 6 to 40 supply voltage range.
- High gain bandwidth product (10 MHz).
- Low cost and readily available.

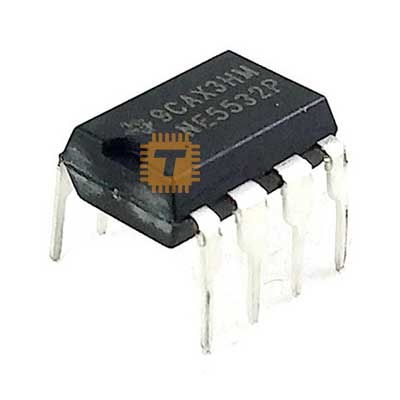
[picture p26: figure]

### 1. Voltage Rating Higher than the input voltage, typically 1.2 to

1.5 (22.5 V).

### 2. Current Rating Should be able to handle peak current, so at

least 1 A (2 A is recommended for safety).

### 3. Switching Voltage: 0 to −15 V

Selected MOSFET: IRF9540
- Voltage Rating: VDS = 100 V (> 22.5 V)
- Current Rating: ID = 19 A (>> 2 A)
- Gate-source threshold voltage -2 to -4 V.

### 1. Voltage Rating: Higher than the input voltage, typically 1.2 to

1.5 × Vin (22.5 V).
2. Current Rating: Should handle load current, at least 1 A.

### 3. Fast Switching: Required to reduce switching losses in PWM

operation.

Selected Diode: 1N5819 (Schottky)
- Reverse Voltage Rating: VRRM = 40 V (> 22.5 V)
- Forward Current Rating: IF = 1 A
- Forward Voltage Drop: VF ≈ 0.45 V to 0.6 V (Lower than standard 0.7 V for higher efficiency)

Inductor Selection

### 1. Inductance: Based on ripple current requirement 2. Current Rating: IL ≥ Ipeak

Capacitor Selection

### 1. Capacitance: Based on output voltage ripple 2. Low ESR: Reduces ripple

Selected Inductor and Capacitor
- L = 2.2 mH
- C = 33 µF

# Results & Comparison

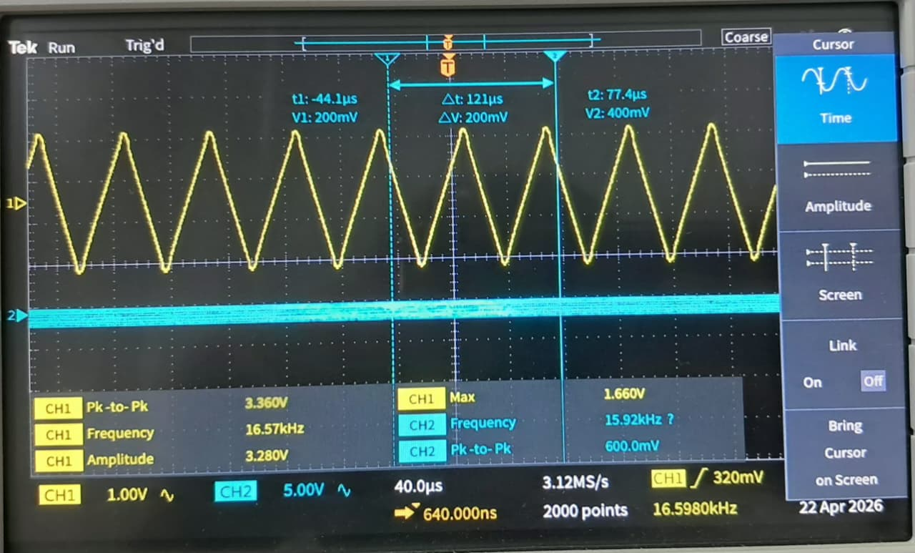
[picture p27: figure]

- The obtained frequency was 16.57 kHz. (< 20 kHz)
- Actual Vpp = 3.36 V. (< 4 V)

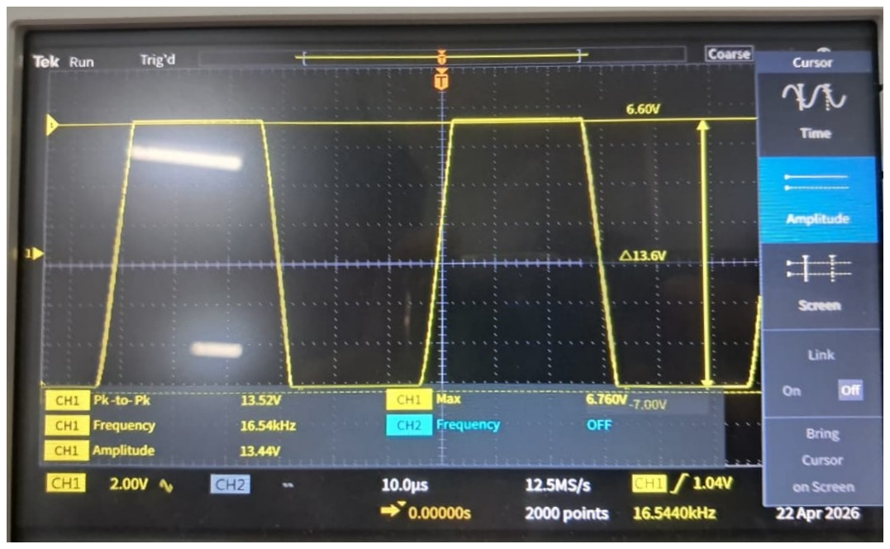
[picture p28: figure]

- Vpp = 13.6 V and f = 16.54 kHz.
- Practical Op-Amp slew rate =¹³.52 V 5.8 µs = 2.33 V µs

−1
. This is
much slower than the expected value.
- 16.79% Lost in Duty cycle.

# Thank you!
