SenudaHR/Buck-Converter-Design/(list of files, drawings)

Other design files:
PCB_Project/PCB1.PcbDoc
PCB_Project/PCB_Project.PrjPcb
PCB_Project/Sheet1.SchDoc
